haxeko/h2-watterleak-sensor/docs/img/sch/sheet-1.png

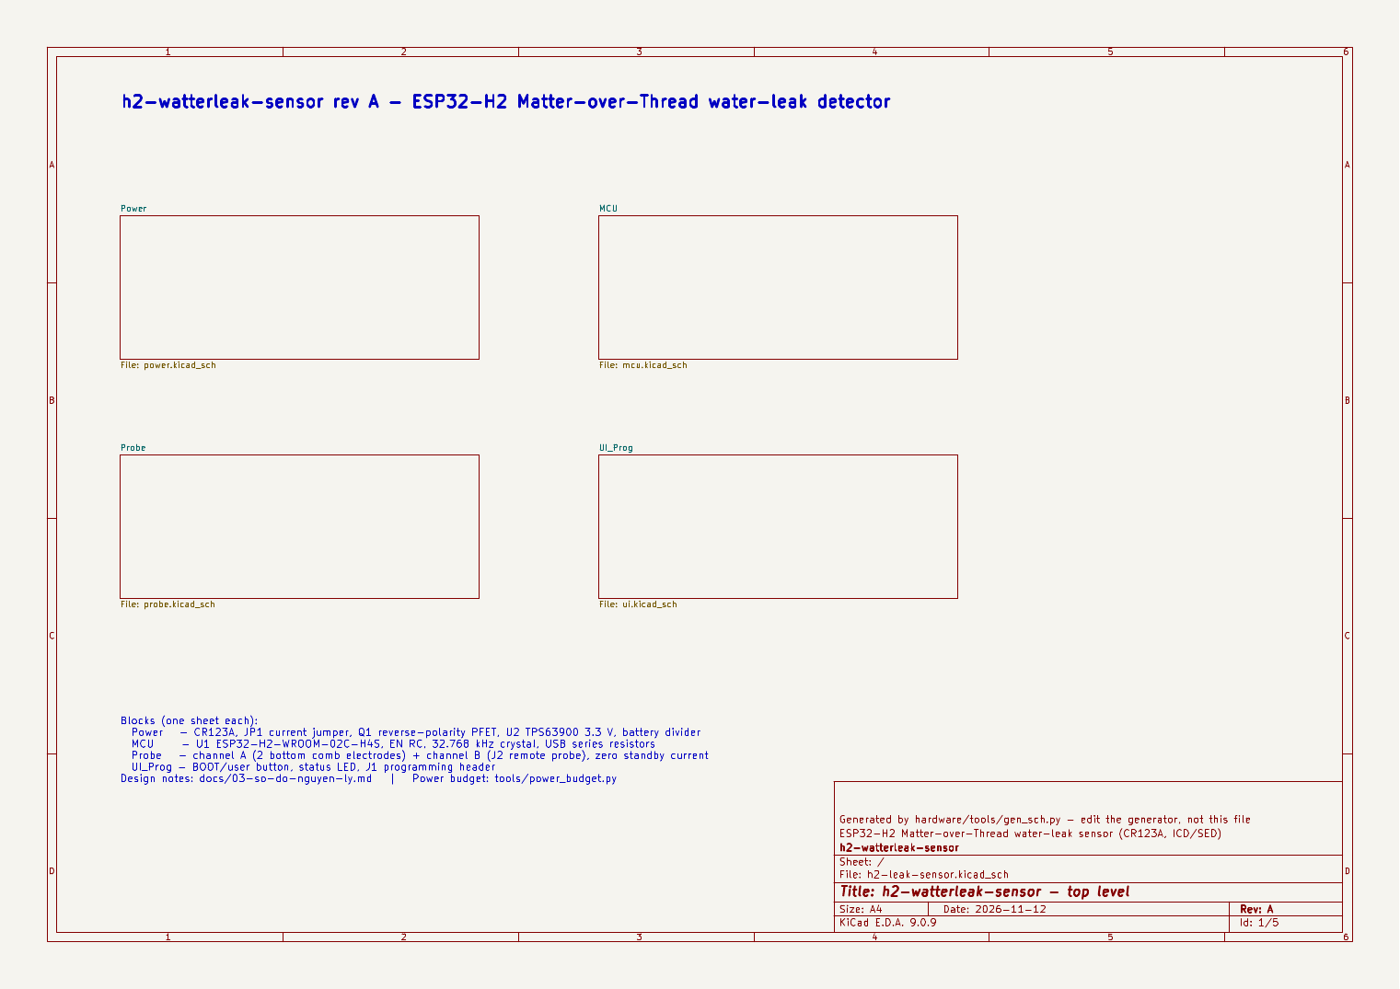
docs/img/sch/sheet-1.png
