haxeko/h2-watterleak-sensor/hardware/h2-leak-sensor/fab/h2-leak-sensor_bom_jlc.csv

Comment | Designator | Footprint | LCSC Part # | MPN | Qty
CR123A | BT1 | BatteryHolder_Bulgin_BX0123_1xCR123 |  | BX0123 (DigiKey 708-1412-ND) | 1
10u | C1 | C_0603_1608Metric_Pad1.08x0.95mm_HandSolder | C19702 | CL10A106KP8NNNC | 1
22u | C2,C3 | C_0805_2012Metric_Pad1.18x1.45mm_HandSolder | C45783 | CL21A226MAQNNNE | 2
100n | C4,C5 | C_0603_1608Metric_Pad1.08x0.95mm_HandSolder | C14663 | CC0603KRX7R9BB104 | 2
1u | C6 | C_0603_1608Metric_Pad1.08x0.95mm_HandSolder | C15849 | CL10A105KB8NNNC | 1
12p | C7,C8 | C_0603_1608Metric_Pad1.08x0.95mm_HandSolder | C38523 | CL10C120JB8NNNC | 2
10n | C9,C10 | C_0603_1608Metric_Pad1.08x0.95mm_HandSolder | C57112 | 0603B103K500NT | 2
1n | C11 | C_0603_1608Metric_Pad1.08x0.95mm_HandSolder | C1588 | CL10B102KB8NNNC | 1
PESD5V0S1BA | D1,D2,D3,D4,D5 | D_SOD-323_HandSoldering | C19224 | PESD5V0S1BA,115 | 5
PROG | J1 | PinHeader_1x08_P2.54mm_Vertical |  | 2.54 mm 1x08 header / pogo pads | 1
Remote probe | J2 | JST_PH_S2B-PH-K_1x02_P2.00mm_Horizontal | C173752 | S2B-PH-K-S(LF)(SN) | 1
2.2u | L1 | L_Sunlord_WPN4020H_HandSolder | C98361 | WPN4020H2R2MT | 1
Red | LED1 | LED_0603_1608Metric_Pad1.05x0.95mm_HandSolder | C2286 | KT-0603R | 1
DMP2035U-7 | Q1 | SOT-23_Handsoldering | C110499 | DMP2035U-7 | 1
AO3400A | Q2,Q3,Q4 | SOT-23_Handsoldering | C20917 | AO3400A | 3
0R | R1,R2 | R_0603_1608Metric_Pad0.98x0.95mm_HandSolder | C21189 | 0603WAF0000T5E | 2
16.2k | R3 | R_0603_1608Metric_Pad0.98x0.95mm_HandSolder | C22885 | 0603WAF1622T5E | 1
100k | R4,R5 | R_0603_1608Metric_Pad0.98x0.95mm_HandSolder | C25803 | 0603WAF1003T5E | 2
1M | R6,R14,R17 | R_0603_1608Metric_Pad0.98x0.95mm_HandSolder | C22935 | 0603WAF1004T5E | 3
10k | R7,R11,R12,R13,R16,R19 | R_0603_1608Metric_Pad0.98x0.95mm_HandSolder | C25804 | 0603WAF1002T5E | 6
22R | R9,R10 | R_0603_1608Metric_Pad0.98x0.95mm_HandSolder | C23345 | 0603WAF220JT5E | 2
470k | R15,R18 | R_0603_1608Metric_Pad0.98x0.95mm_HandSolder | C23178 | 0603WAF4703T5E | 2
1k | R20 | R_0603_1608Metric_Pad0.98x0.95mm_HandSolder | C21190 | 0603WAF1001T5E | 1
47k | R21 | R_0603_1608Metric_Pad0.98x0.95mm_HandSolder | C25819 | 0603WAF4702T5E | 1
TS-1187A | SW1 | SW_Push_1P1T_XKB_TS-1187A | C318884 | TS-1187A-B-A-B | 1
TPS63900DSKR | U2 | TPS63900_WSON-10_2.5x2.5mm_HandSolder | C1518762 | TPS63900DSKR | 1
32.768kHz 9pF | Y1 | Crystal_SMD_3215-2Pin_3.2x1.5mm | C99010 | Q13FC13500003 | 1
