haxeko/h2-watterleak-sensor/hardware/enclosure/h2-leak-plunger.stl

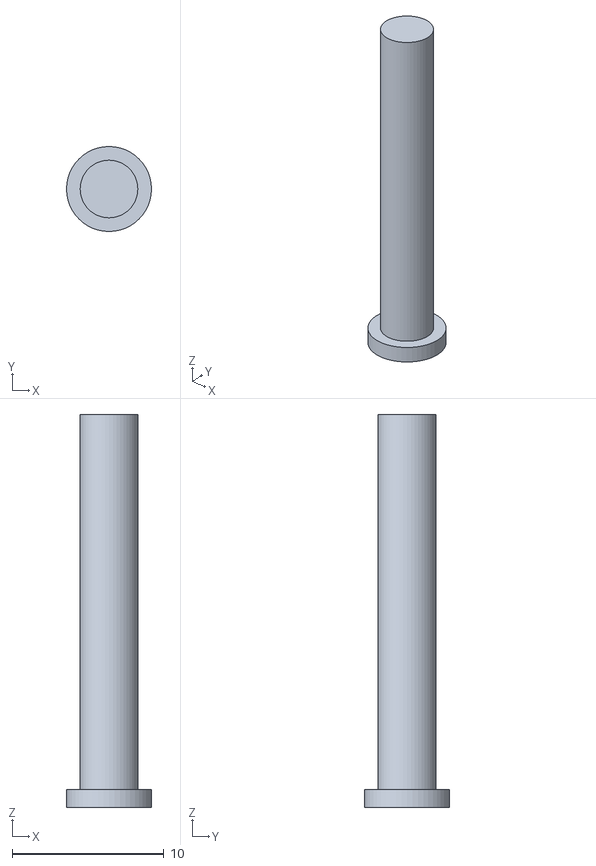
[picture p11: CAD file, 2026-11-12]
hardware/enclosure/h2-leak-plunger.stl
5.60 x 5.60 x 25.9
