haxeko/h2-watterleak-sensor/hardware/enclosure/h2-leak-base.stl

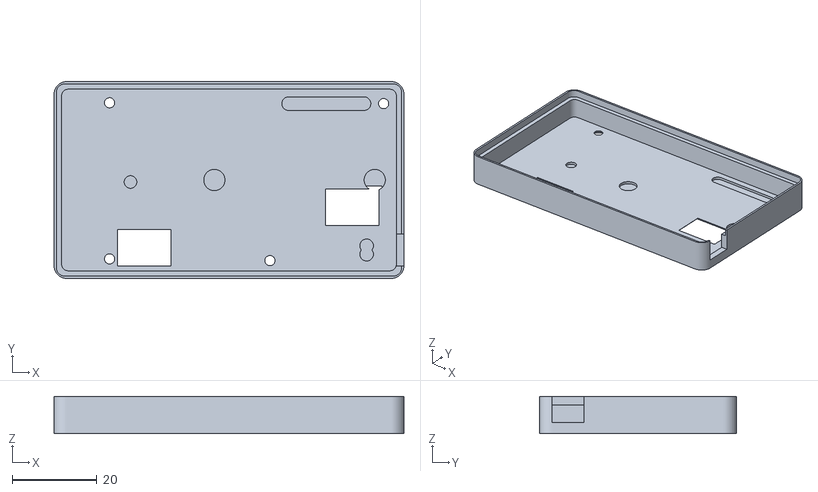
[picture p12: CAD file, 2026-11-12]
hardware/enclosure/h2-leak-base.stl
82.5 x 46.4 x 8.80
