haxeko/h2-watterleak-sensor/hardware/enclosure/h2-leak-lid.stl

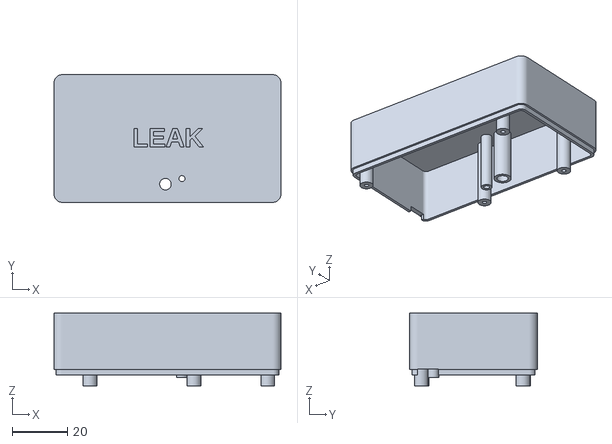
[picture p13: CAD file, 2026-11-12]
hardware/enclosure/h2-leak-lid.stl
82.5 x 46.4 x 26.4
