haxeko/h2-watterleak-sensor/hardware/h2-leak-sensor/h2-leak-sensor_schematic.pdf

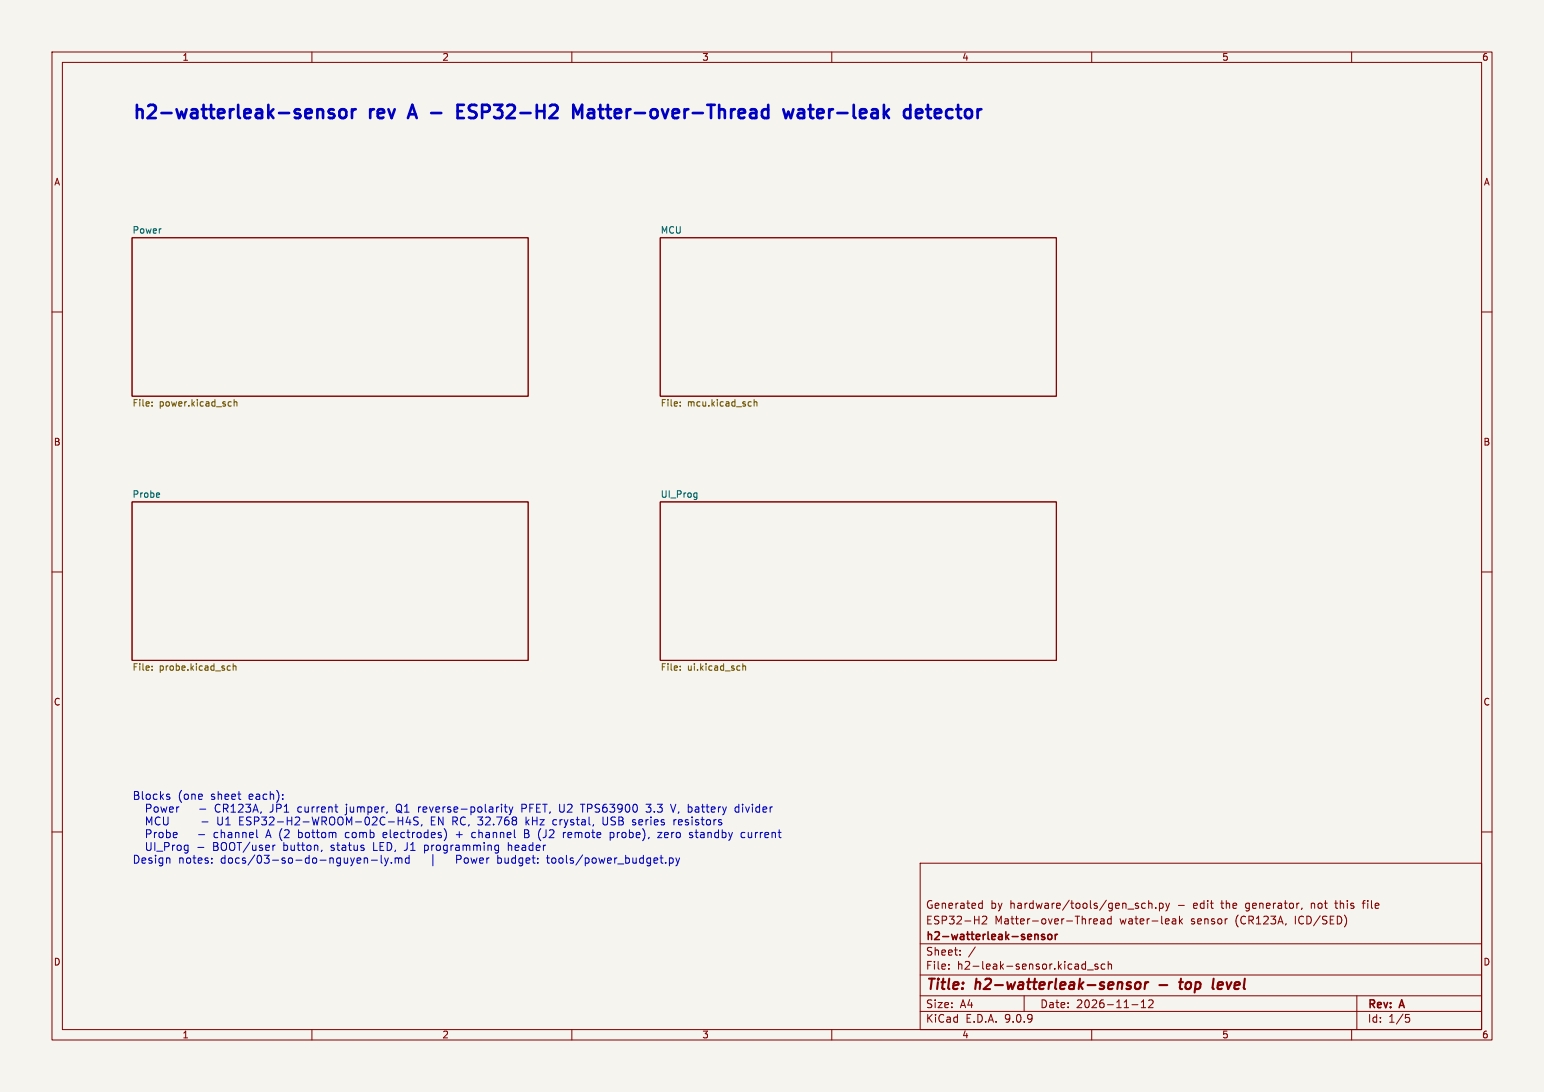
[picture p14: page 1]

File: mcu.kicad_sch Probe File: probe.kicad_sch

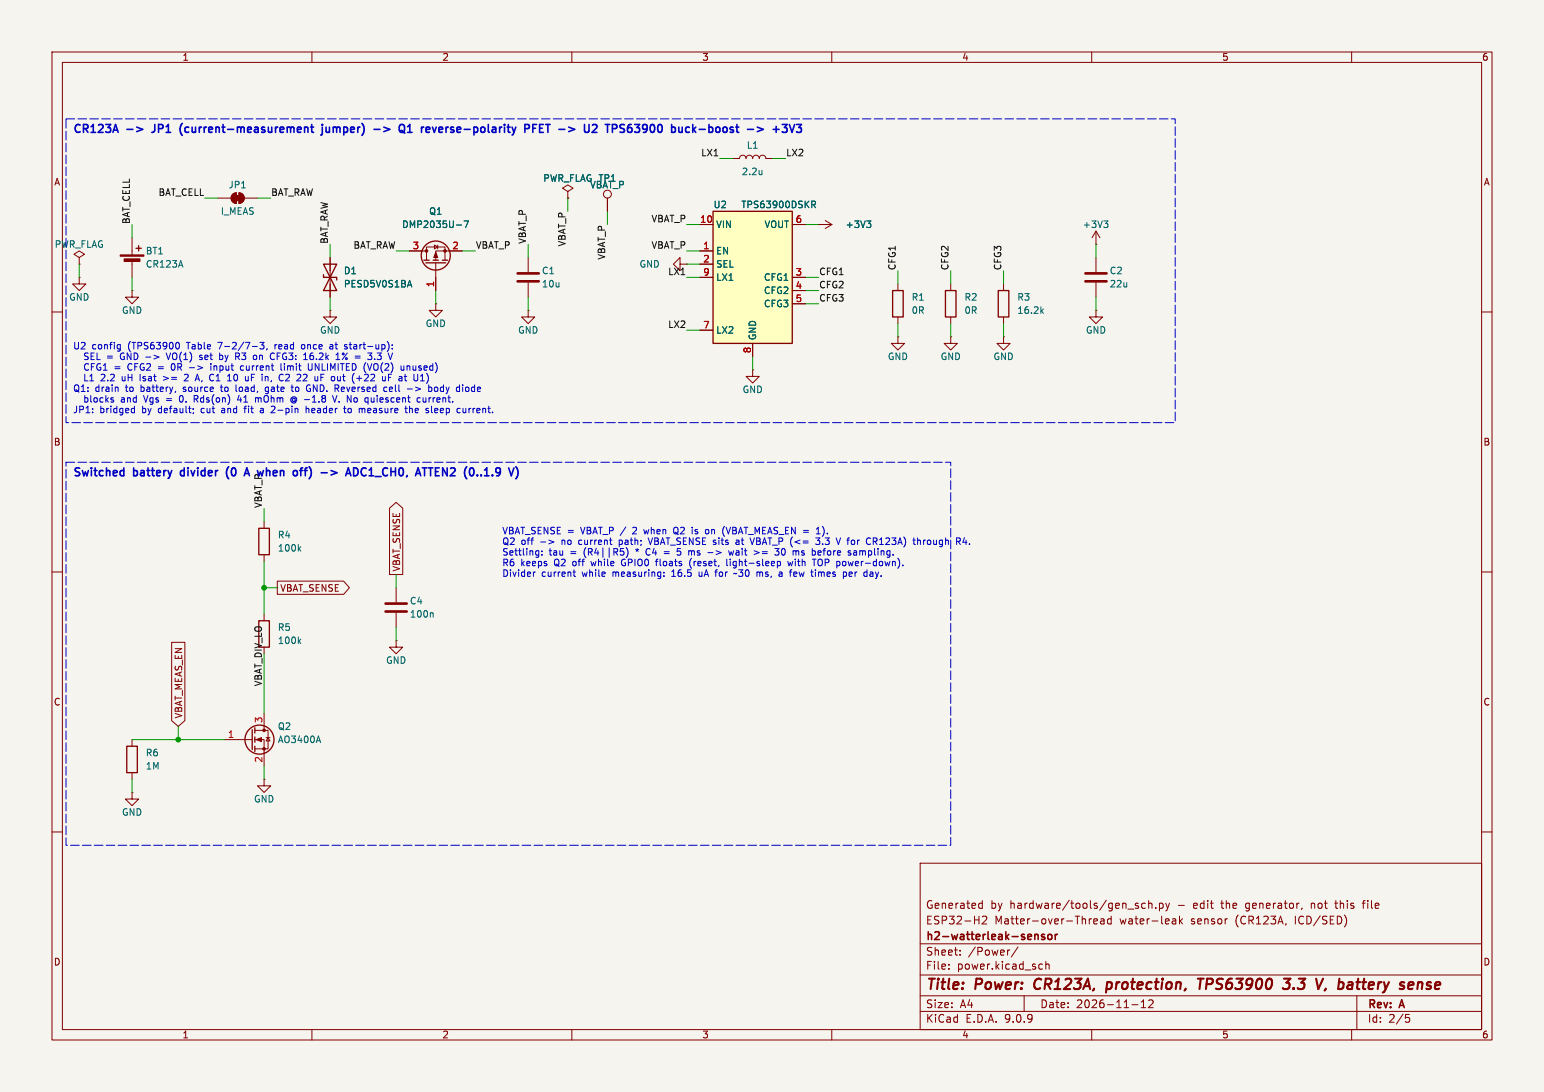
[picture p15: page 2]

8 VOUT 6 CFG1 3 CFG2 4 CFG3 5 U2 TPS63900DSKR GND GND GND

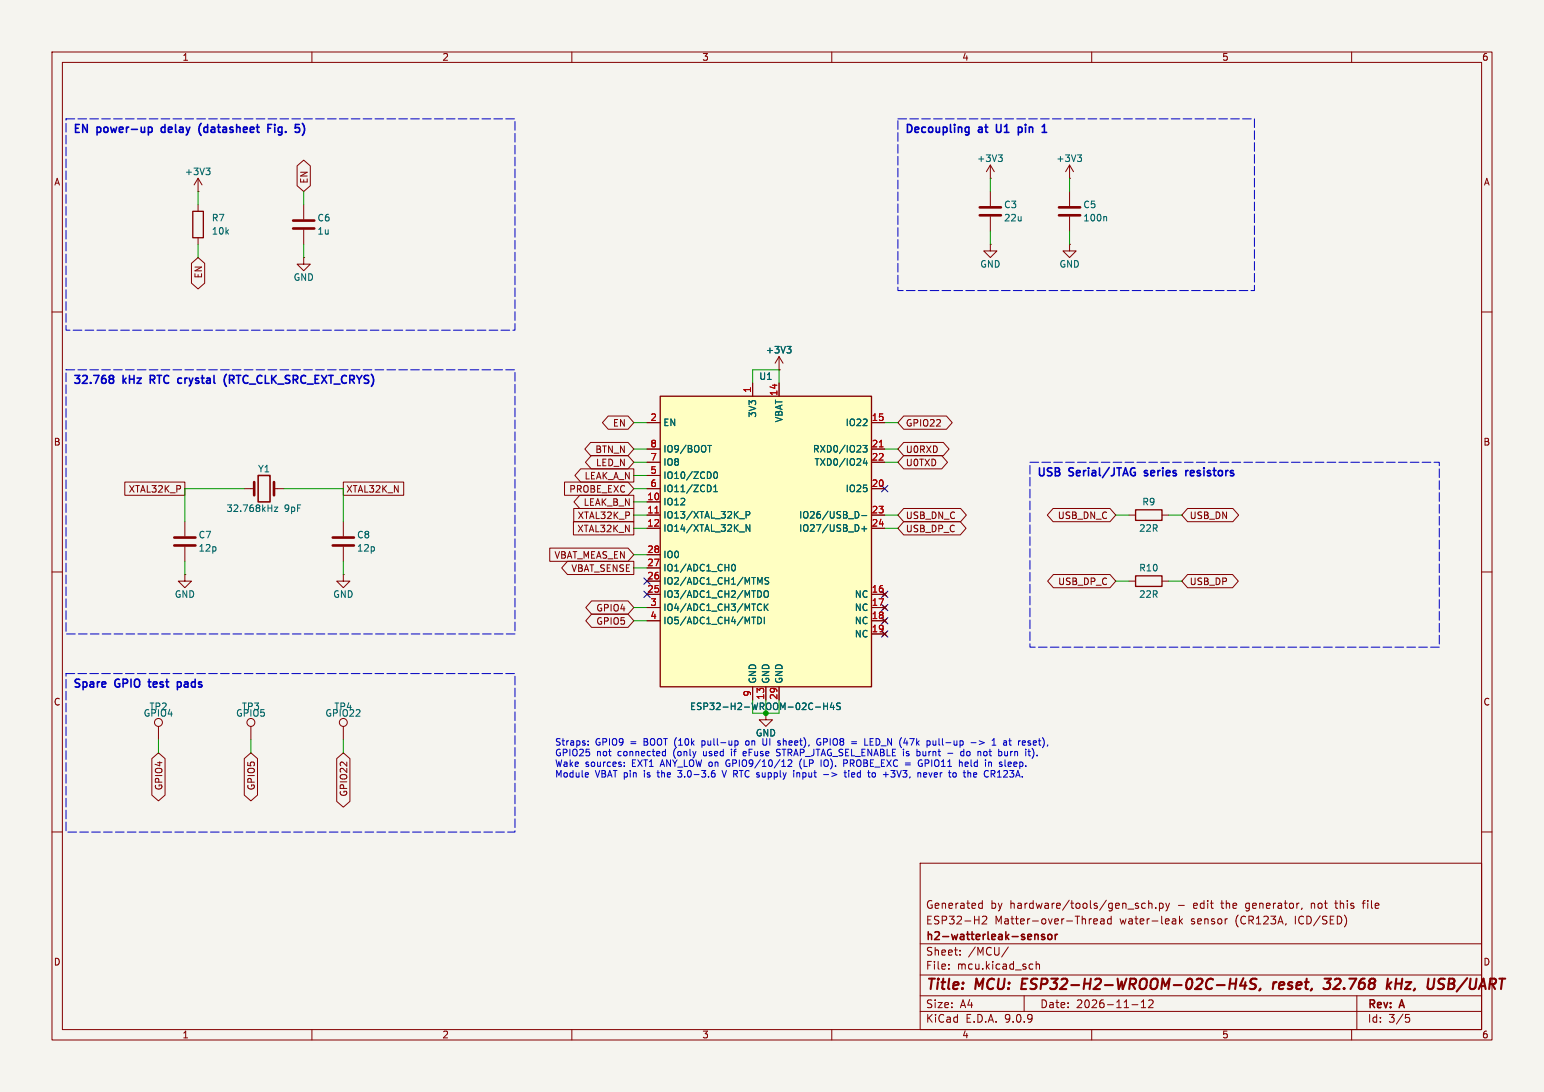
[picture p16: page 3]

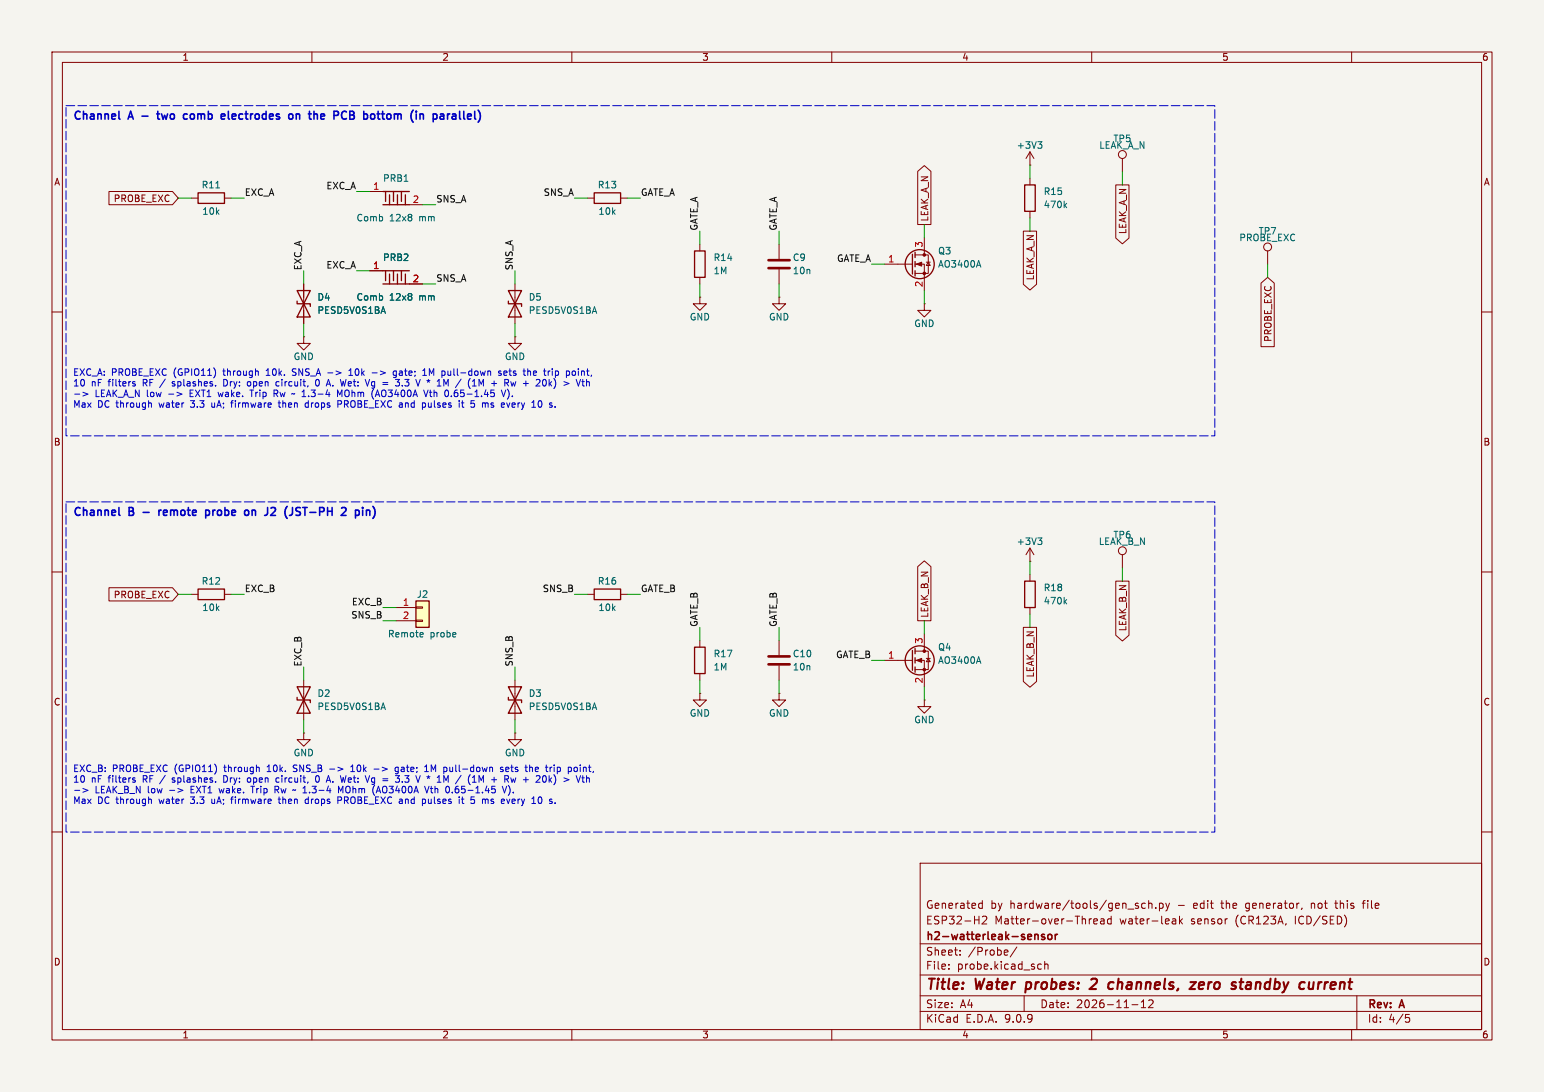
[picture p17: page 4]

Channel A - two comb electrodes on the PCB bottom (in parallel)

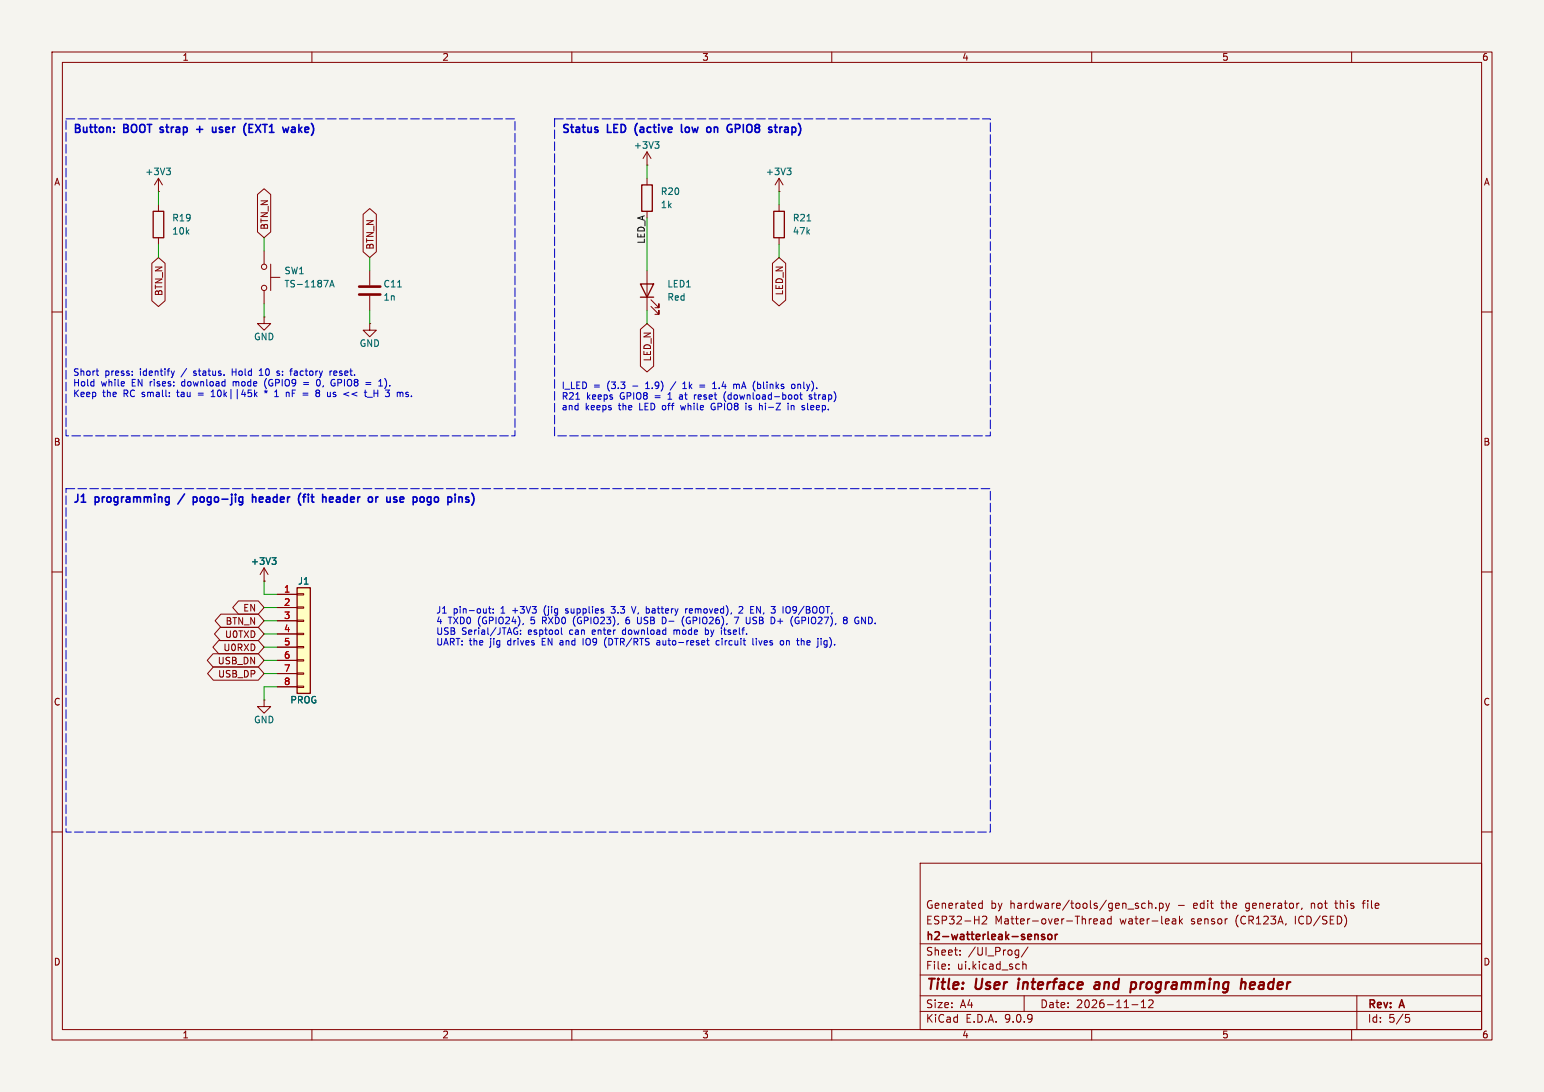
[picture p18: page 5]
