haxeko/h2-watterleak-sensor/hardware/h2-leak-sensor/fab/h2-leak-sensor_assembly_bottom.pdf

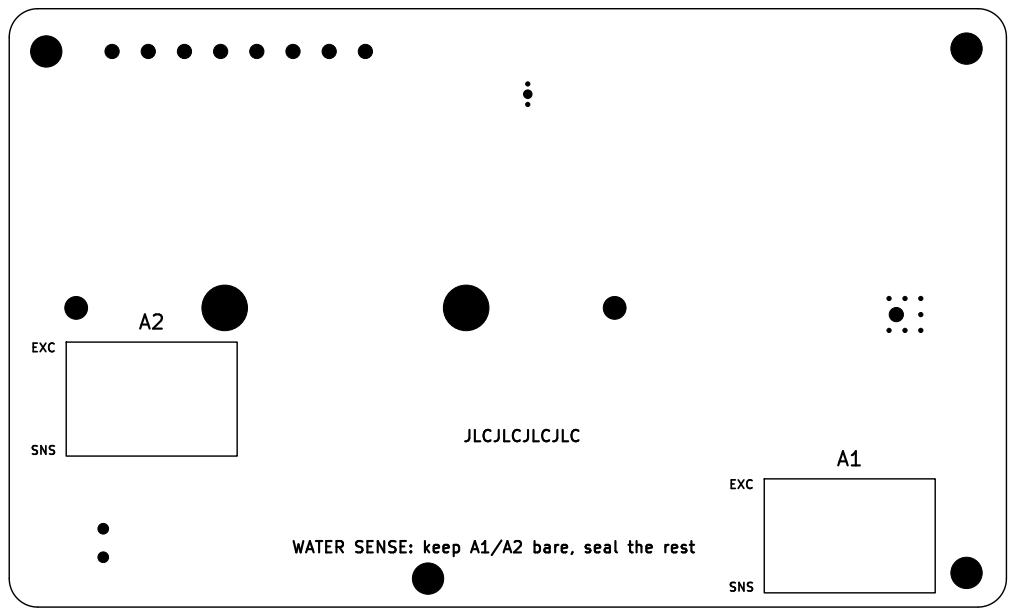
[picture p19: page 1]

Id: 1/1 Title: File: h2-leak-sensor.kicad_pcb Sheet:
