haxeko/h2-watterleak-sensor/hardware/h2-leak-sensor/fab/h2-leak-sensor_assembly_top.pdf

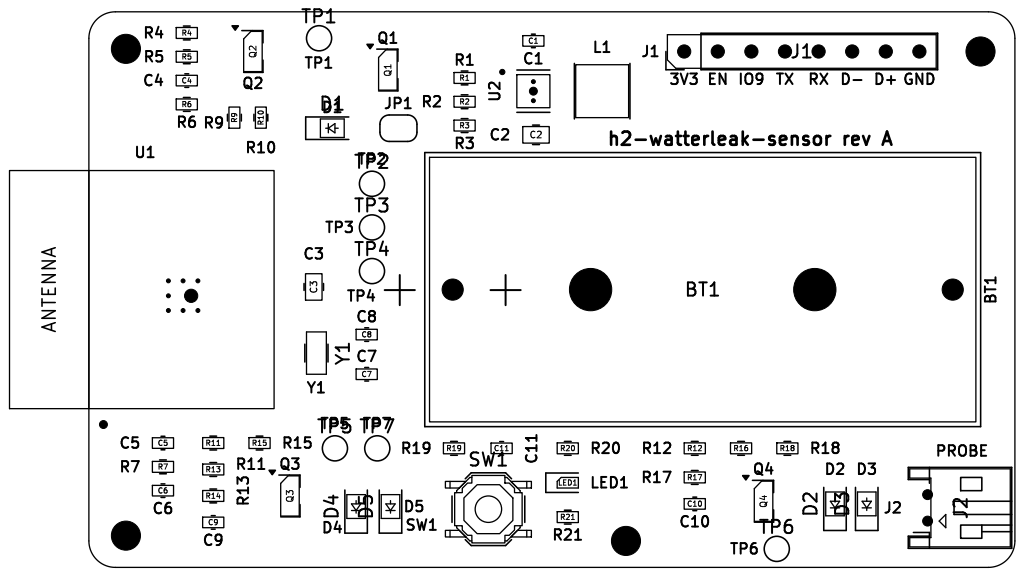
[picture p20: page 1]
