haxeko/h2-watterleak-sensor/hardware/h2-leak-sensor/h2-leak-sensor.kicad_pcb

## KiCad design hardware/h2-leak-sensor/h2-leak-sensor.kicad_pcb (2026-11-12)

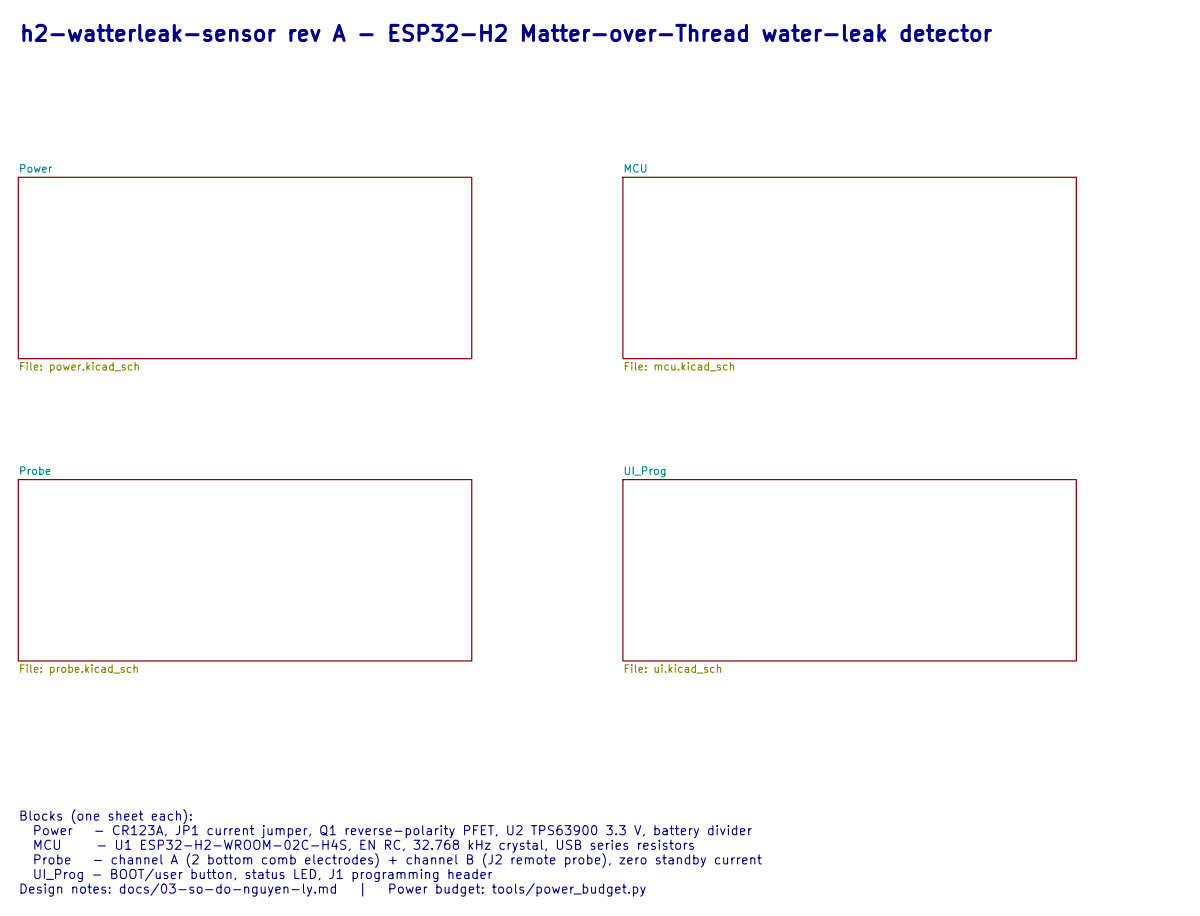
[picture p21: schematic h2-leak-sensor.kicad_sch, h2-watterleak-sensor - top level]

Notes on the sheet:
h2-watterleak-sensor rev A - ESP32-H2 Matter-over-Thread water-leak detector
Blocks (one sheet each): Power - CR123A, JP1 current jumper, Q1 reverse-polarity PFET, U2 TPS63900 3.3 V, battery divider MCU - U1 ESP32-H2-WROOM-02C-H4S, EN RC, 32.768 kHz crystal, USB series resistors Probe - channel A (2 bottom comb electrodes) + channel B (J2 remote probe), zero standby current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

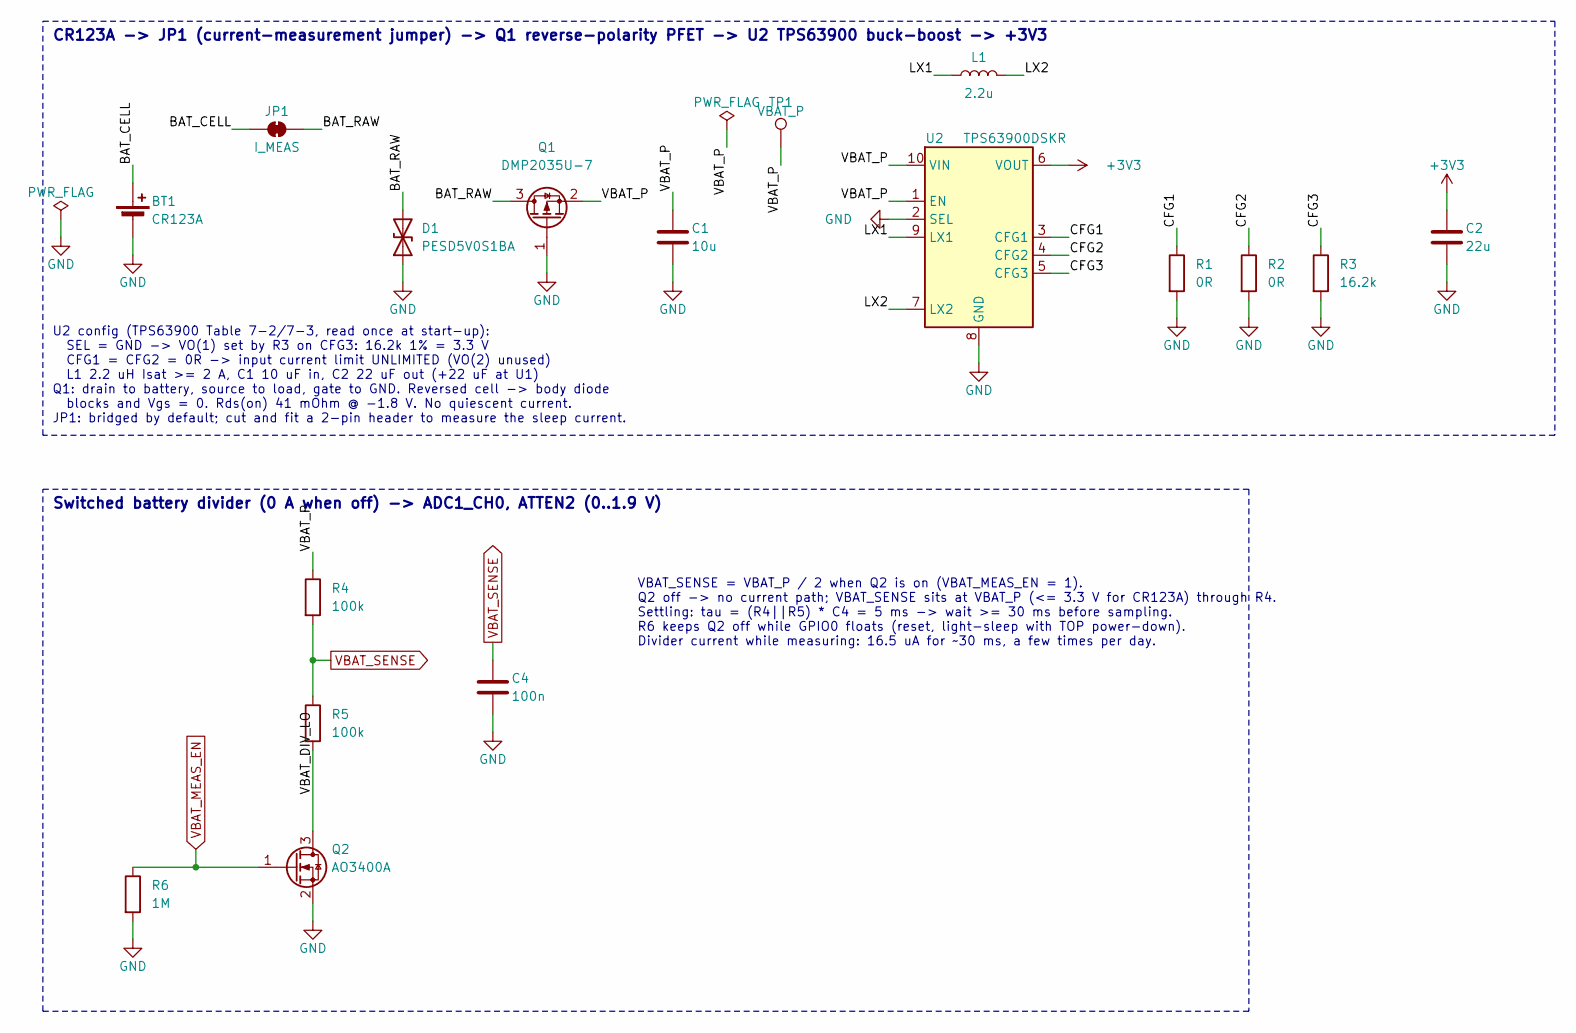
[picture p22: schematic power.kicad_sch, Power: CR123A, protection, TPS63900 3.3 V, battery sense]

Parts:
BT1: CR123A; BatteryHolder_Bulgin_BX0123_1xCR123; MPN BX0123 (DigiKey 708-1412-ND)
C1: 10u; C_0603_1608Metric_Pad1.08x0.95mm_HandSolder; MPN CL10A106KP8NNNC; LCSC C19702
C2: 22u; C_0805_2012Metric_Pad1.18x1.45mm_HandSolder; MPN CL21A226MAQNNNE; LCSC C45783
C4: 100n; C_0603_1608Metric_Pad1.08x0.95mm_HandSolder; MPN CC0603KRX7R9BB104; LCSC C14663
D1: PESD5V0S1BA; D_SOD-323_HandSoldering; MPN PESD5V0S1BA,115; LCSC C19224
JP1: I_MEAS; SolderJumper-2_P1.3mm_Bridged_RoundedPad1.0x1.5mm; MPN solder jumper (bridged)
L1: 2.2u; L_Sunlord_WPN4020H_HandSolder; MPN WPN4020H2R2MT; LCSC C98361
Q1: DMP2035U-7; SOT-23_Handsoldering; MPN DMP2035U-7; LCSC C110499
Q2: AO3400A; SOT-23_Handsoldering; MPN AO3400A; LCSC C20917
R1, R2: 0R; R_0603_1608Metric_Pad0.98x0.95mm_HandSolder; MPN 0603WAF0000T5E; LCSC C21189
R3: 16.2k; R_0603_1608Metric_Pad0.98x0.95mm_HandSolder; MPN 0603WAF1622T5E; LCSC C22885
R4, R5: 100k; R_0603_1608Metric_Pad0.98x0.95mm_HandSolder; MPN 0603WAF1003T5E; LCSC C25803
R6: 1M; R_0603_1608Metric_Pad0.98x0.95mm_HandSolder; MPN 0603WAF1004T5E; LCSC C22935
TP1: VBAT_P; TestPoint_Pad_D1.5mm; MPN test pad
U2: TPS63900DSKR; TPS63900_WSON-10_2.5x2.5mm_HandSolder; MPN TPS63900DSKR; LCSC C1518762

Connections:
+3V3: C2.1, U2.6 (VOUT); also elsewhere on the board
/Power/BAT_CELL: BT1.1 (+), JP1.1 (A)
/Power/BAT_RAW: D1.2 (A2), JP1.2 (B), Q1.3 (D)
/Power/CFG1: R1.1, U2.3 (CFG1)
/Power/CFG2: R2.1, U2.4 (CFG2)
/Power/CFG3: R3.1, U2.5 (CFG3)
/Power/LX1: L1.1, U2.9 (LX1)
/Power/LX2: L1.2, U2.7 (LX2)
/Power/VBAT_DIV_LO: Q2.3 (D), R5.2
/Power/VBAT_P: C1.1, Q1.2 (S), R4.1, TP1.1, U2.1 (EN), U2.10 (VIN)
GND: BT1.2 (-), C1.2, C2.2, C4.2, D1.1 (A1), Q1.1 (G), Q2.2 (S), R1.2, R2.2, R3.2, R6.2, U2.2 (SEL), U2.8 (GND), U2.11 (GND); also elsewhere on the board
VBAT_MEAS_EN: Q2.1 (G), R6.1; also elsewhere on the board
VBAT_SENSE: C4.1, R4.2, R5.1; also elsewhere on the board

Notes on the sheet:
CR123A -> JP1 (current-measurement jumper) -> Q1 reverse-polarity PFET -> U2 TPS63900 buck-boost -> +3V3
U2 config (TPS63900 Table 7-2/7-3, read once at start-up): SEL = GND -> VO(1) set by R3 on CFG3: 16.2k 1% = 3.3 V CFG1 = CFG2 = 0R -> input current limit UNLIMITED (VO(2) unused) L1 2.2 uH Isat >= 2 A, C1 10 uF in, C2 22 uF out (+22 uF at U1) Q1: drain to battery, source to load, gate to GND. Rever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
Switched battery divider (0 A when off) -> ADC1_CH0, ATTEN2 (0..1.9 V)
VBAT_SENSE = VBAT_P / 2 when Q2 is on (VBAT_MEAS_EN = 1). Q2 off -> no current path; VBAT_SENSE sits at VBAT_P (<= 3.3 V for CR123A) through R4. Settling: tau = (R4||R5) * C4 = 5 ms -> wait >= 30 ms before sampling. R6 keeps Q2 off while GPIO0 floats (reset, light-sleep with TOP power-down). Divide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

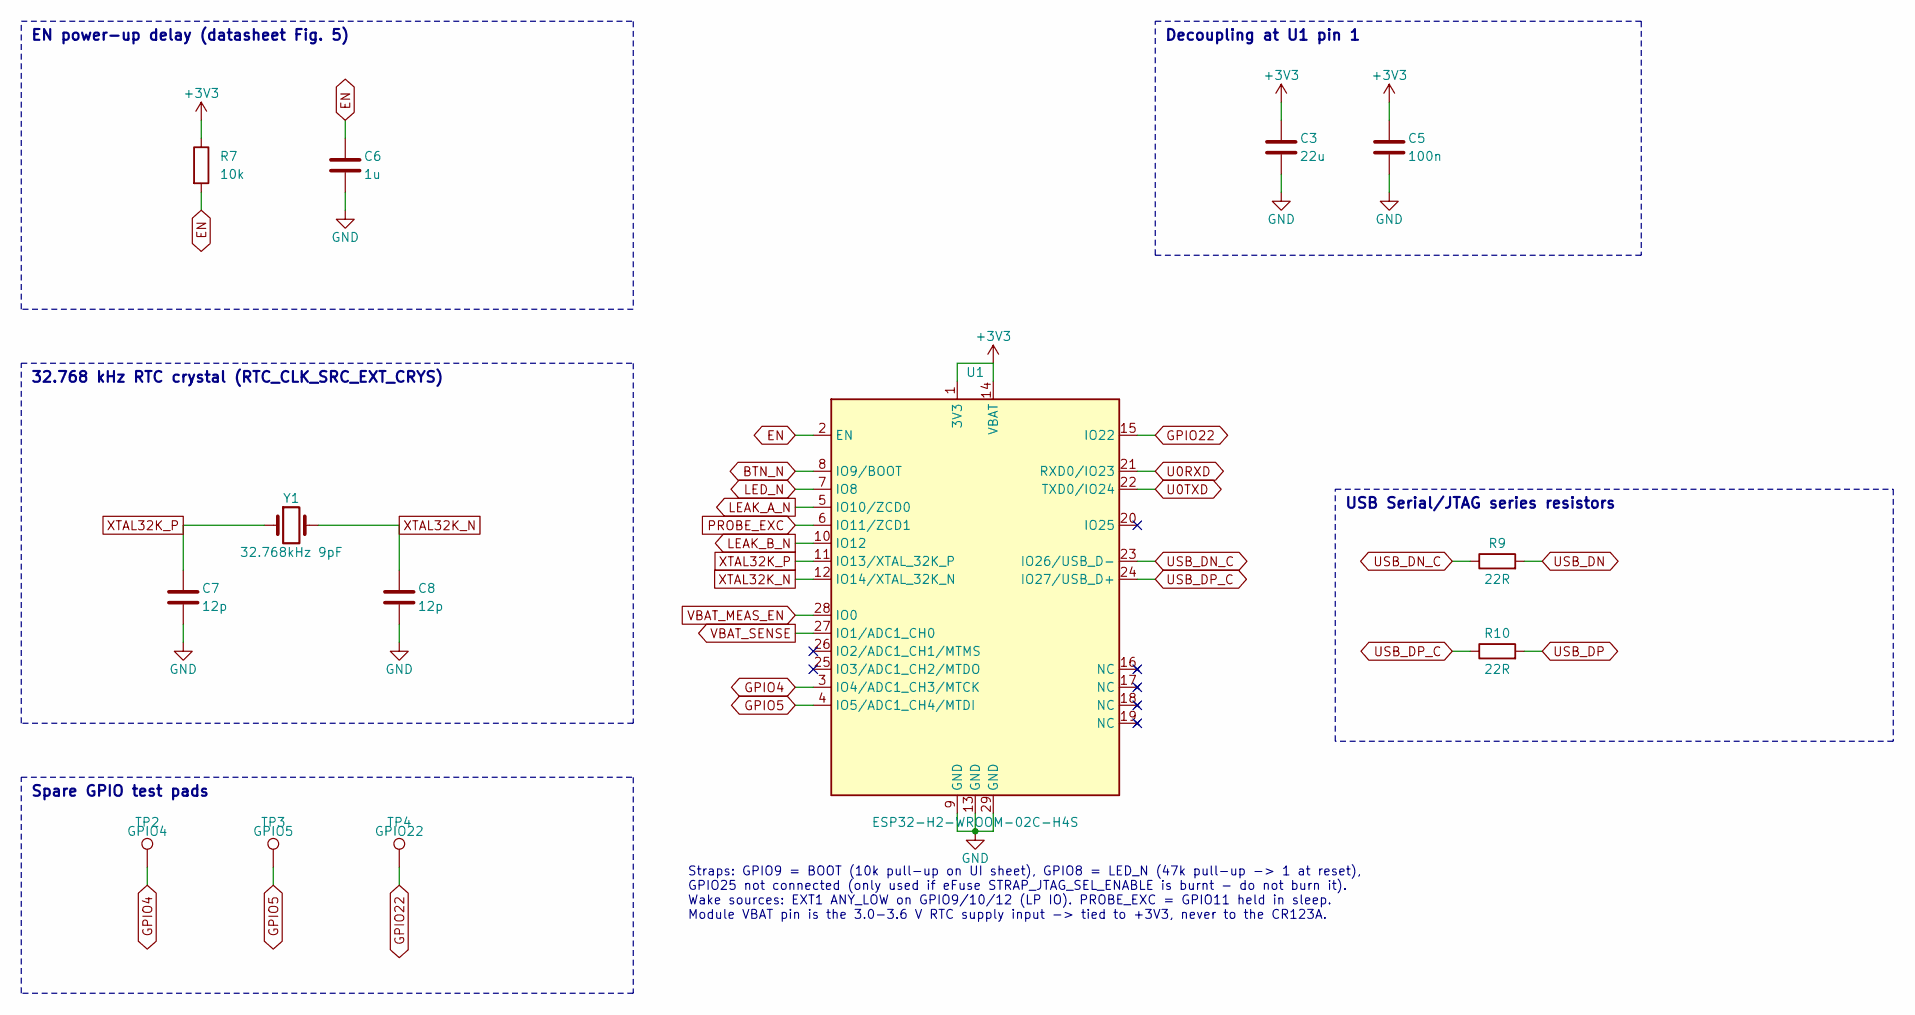
[picture p23: schematic mcu.kicad_sch, MCU: ESP32-H2-WROOM-02C-H4S, reset, 32.768 kHz, USB/UART]

Parts:
C3: 22u; C_0805_2012Metric_Pad1.18x1.45mm_HandSolder; MPN CL21A226MAQNNNE; LCSC C45783
C5: 100n; C_0603_1608Metric_Pad1.08x0.95mm_HandSolder; MPN CC0603KRX7R9BB104; LCSC C14663
C6: 1u; C_0603_1608Metric_Pad1.08x0.95mm_HandSolder; MPN CL10A105KB8NNNC; LCSC C15849
C7, C8: 12p; C_0603_1608Metric_Pad1.08x0.95mm_HandSolder; MPN CL10C120JB8NNNC; LCSC C38523
R7: 10k; R_0603_1608Metric_Pad0.98x0.95mm_HandSolder; MPN 0603WAF1002T5E; LCSC C25804
R9, R10: 22R; R_0603_1608Metric_Pad0.98x0.95mm_HandSolder; MPN 0603WAF220JT5E; LCSC C23345
TP2: GPIO4; TestPoint_Pad_D1.5mm; MPN test pad
TP3: GPIO5; TestPoint_Pad_D1.5mm; MPN test pad
TP4: GPIO22; TestPoint_Pad_D1.5mm; MPN test pad
U1: ESP32-H2-WROOM-02C-H4S; ESP32-H2-WROOM-02C; MPN ESP32-H2-WROOM-02C-H4S
Y1: 32.768kHz 9pF; Crystal_SMD_3215-2Pin_3.2x1.5mm; MPN Q13FC13500003; LCSC C99010

Connections:
+3V3: C3.1, C5.1, R7.1, U1.1 (3V3), U1.14 (VBAT); also elsewhere on the board
BTN_N: U1.8 (IO9/BOOT); also elsewhere on the board
EN: C6.1, R7.2, U1.2 (EN); also elsewhere on the board
GND: C3.2, C5.2, C6.2, C7.2, C8.2, U1.9 (GND), U1.13 (GND), U1.29 (GND); also elsewhere on the board
GPIO4: TP2.1, U1.3 (IO4/ADC1_CH3/MTCK)
GPIO5: TP3.1, U1.4 (IO5/ADC1_CH4/MTDI)
GPIO22: TP4.1, U1.15 (IO22)
LEAK_A_N: U1.5 (IO10/ZCD0); also elsewhere on the board
LEAK_B_N: U1.10 (IO12); also elsewhere on the board
LED_N: U1.7 (IO8); also elsewhere on the board
PROBE_EXC: U1.6 (IO11/ZCD1); also elsewhere on the board
U0RXD: U1.21 (RXD0/IO23); also elsewhere on the board
U0TXD: U1.22 (TXD0/IO24); also elsewhere on the board
USB_DN: R9.2; also elsewhere on the board
USB_DN_C: R9.1, U1.23 (IO26/USB_D-)
USB_DP: R10.2; also elsewhere on the board
USB_DP_C: R10.1, U1.24 (IO27/USB_D+)
VBAT_MEAS_EN: U1.28 (IO0); also elsewhere on the board
VBAT_SENSE: U1.27 (IO1/ADC1_CH0); also elsewhere on the board
XTAL32K_N: C8.1, U1.12 (IO14/XTAL_32K_N), Y1.2
XTAL32K_P: C7.1, U1.11 (IO13/XTAL_32K_P), Y1.1

Notes on the sheet:
Decoupling at U1 pin 1
EN power-up delay (datasheet Fig. 5)
32.768 kHz RTC crystal (RTC_CLK_SRC_EXT_CRYS)
USB Serial/JTAG series resistors
Spare GPIO test pads
Straps: GPIO9 = BOOT (10k pull-up on UI sheet), GPIO8 = LED_N (47k pull-up -> 1 at reset), GPIO25 not connected (only used if eFuse STRAP_JTAG_SEL_ENABLE is burnt - do not burn it). Wake sources: EXT1 ANY_LOW on GPIO9/10/12 (LP IO). PROBE_EXC = GPIO11 held in sleep. Module VBAT pin is the 3.0-3.6 V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

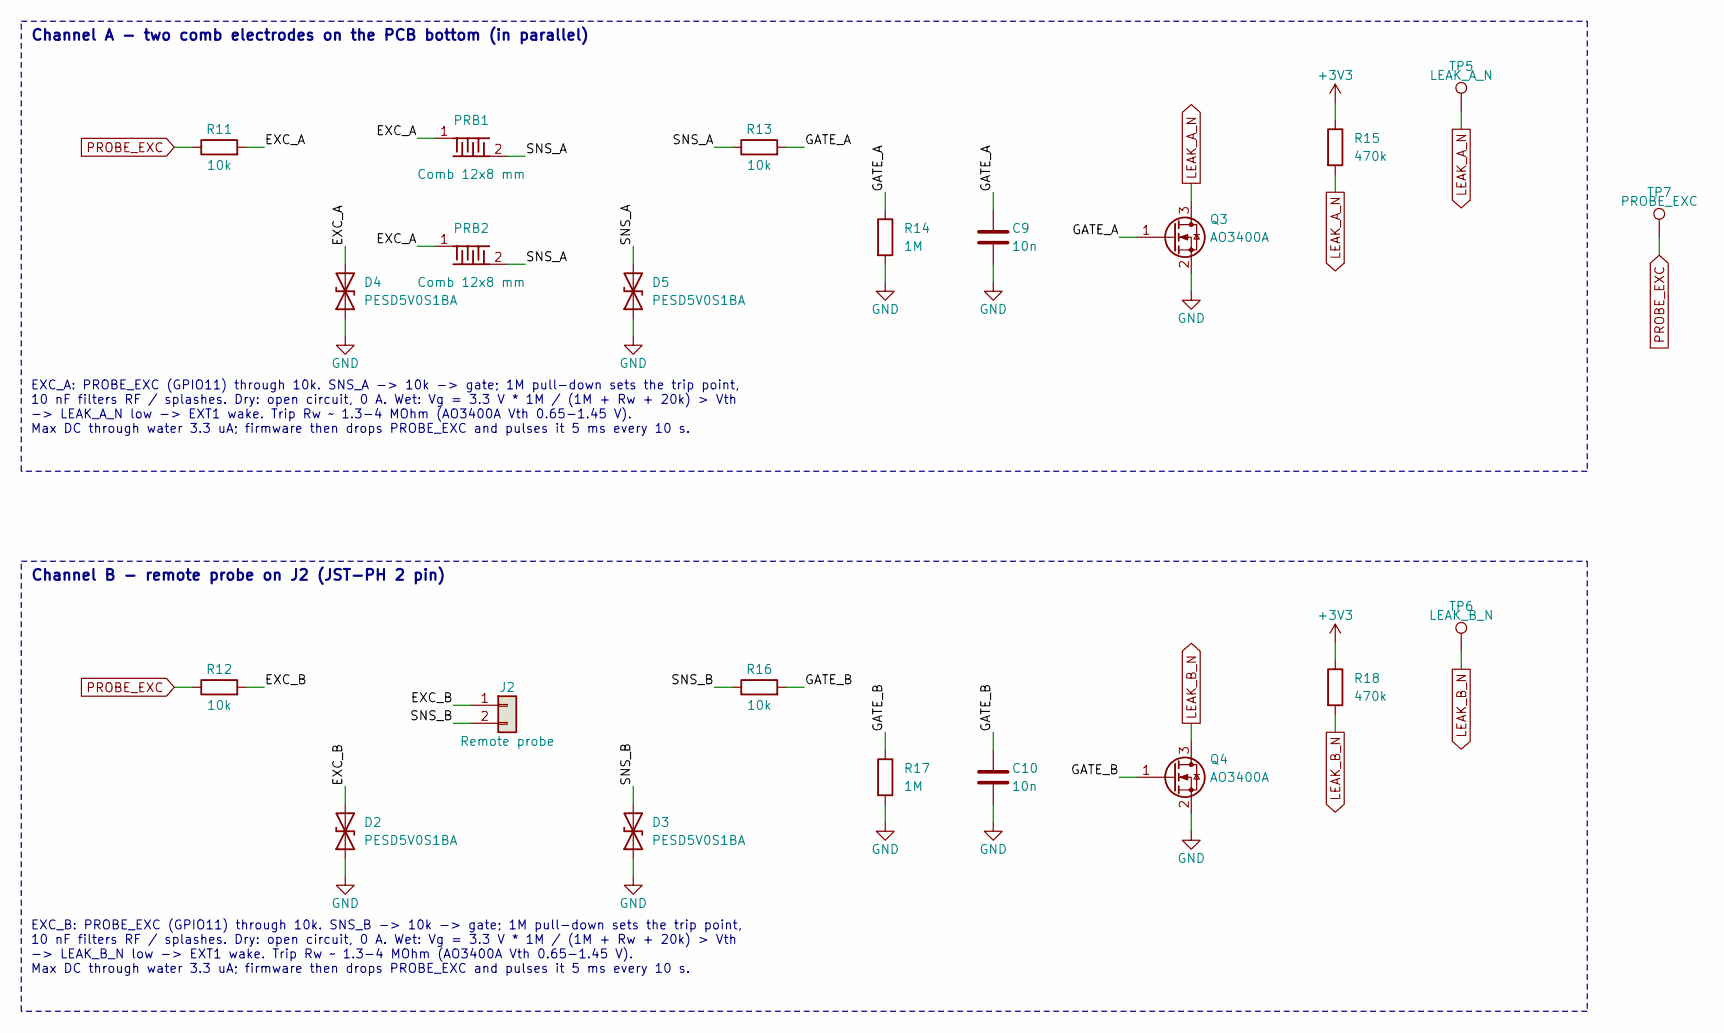
[picture p24: schematic probe.kicad_sch, Water probes: 2 channels, zero standby current]

Parts:
C9, C10: 10n; C_0603_1608Metric_Pad1.08x0.95mm_HandSolder; MPN 0603B103K500NT; LCSC C57112
D2, D3, D4, D5: PESD5V0S1BA; D_SOD-323_HandSoldering; MPN PESD5V0S1BA,115; LCSC C19224
J2: Remote probe; JST_PH_S2B-PH-K_1x02_P2.00mm_Horizontal; MPN S2B-PH-K-S(LF)(SN); LCSC C173752
PRB1, PRB2: Comb 12x8 mm; Electrode_Comb_12x8mm; MPN PCB copper (ENIG)
Q3, Q4: AO3400A; SOT-23_Handsoldering; MPN AO3400A; LCSC C20917
R11, R12, R13, R16: 10k; R_0603_1608Metric_Pad0.98x0.95mm_HandSolder; MPN 0603WAF1002T5E; LCSC C25804
R14, R17: 1M; R_0603_1608Metric_Pad0.98x0.95mm_HandSolder; MPN 0603WAF1004T5E; LCSC C22935
R15, R18: 470k; R_0603_1608Metric_Pad0.98x0.95mm_HandSolder; MPN 0603WAF4703T5E; LCSC C23178
TP5: LEAK_A_N; TestPoint_Pad_D1.5mm; MPN test pad
TP6: LEAK_B_N; TestPoint_Pad_D1.5mm; MPN test pad
TP7: PROBE_EXC; TestPoint_Pad_D1.5mm; MPN test pad

Connections:
+3V3: R15.1, R18.1; also elsewhere on the board
/Probe/EXC_A: D4.2 (A2), PRB1.1 (EXC), PRB2.1 (EXC), R11.2
/Probe/EXC_B: D2.2 (A2), J2.1, R12.2
/Probe/GATE_A: C9.1, Q3.1 (G), R13.2, R14.1
/Probe/GATE_B: C10.1, Q4.1 (G), R16.2, R17.1
/Probe/SNS_A: D5.2 (A2), PRB1.2 (SNS), PRB2.2 (SNS), R13.1
/Probe/SNS_B: D3.2 (A2), J2.2, R16.1
GND: C9.2, C10.2, D2.1 (A1), D3.1 (A1), D4.1 (A1), D5.1 (A1), Q3.2 (S), Q4.2 (S), R14.2, R17.2; also elsewhere on the board
LEAK_A_N: Q3.3 (D), R15.2, TP5.1; also elsewhere on the board
LEAK_B_N: Q4.3 (D), R18.2, TP6.1; also elsewhere on the board
PROBE_EXC: R11.1, R12.1, TP7.1; also elsewhere on the board

Notes on the sheet:
Channel A - two comb electrodes on the PCB bottom (in parallel)
EXC_A: PROBE_EXC (GPIO11) through 10k. SNS_A -> 10k -> gate; 1M pull-down sets the trip point, 10 nF filters RF / splashes. Dry: open circuit, 0 A. Wet: Vg = 3.3 V * 1M / (1M + Rw + 20k) > Vth -> LEAK_A_N low -> EXT1 wake. Trip Rw ~ 1.3-4 MOhm (AO3400A Vth 0.65-1.45 V). Max DC through water 3.3 uA;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
Channel B - remote probe on J2 (JST-PH 2 pin)
EXC_B: PROBE_EXC (GPIO11) through 10k. SNS_B -> 10k -> gate; 1M pull-down sets the trip point, 10 nF filters RF / splashes. Dry: open circuit, 0 A. Wet: Vg = 3.3 V * 1M / (1M + Rw + 20k) > Vth -> LEAK_B_N low -> EXT1 wake. Trip Rw ~ 1.3-4 MOhm (AO3400A Vth 0.65-1.45 V). Max DC through water 3.3 uA;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

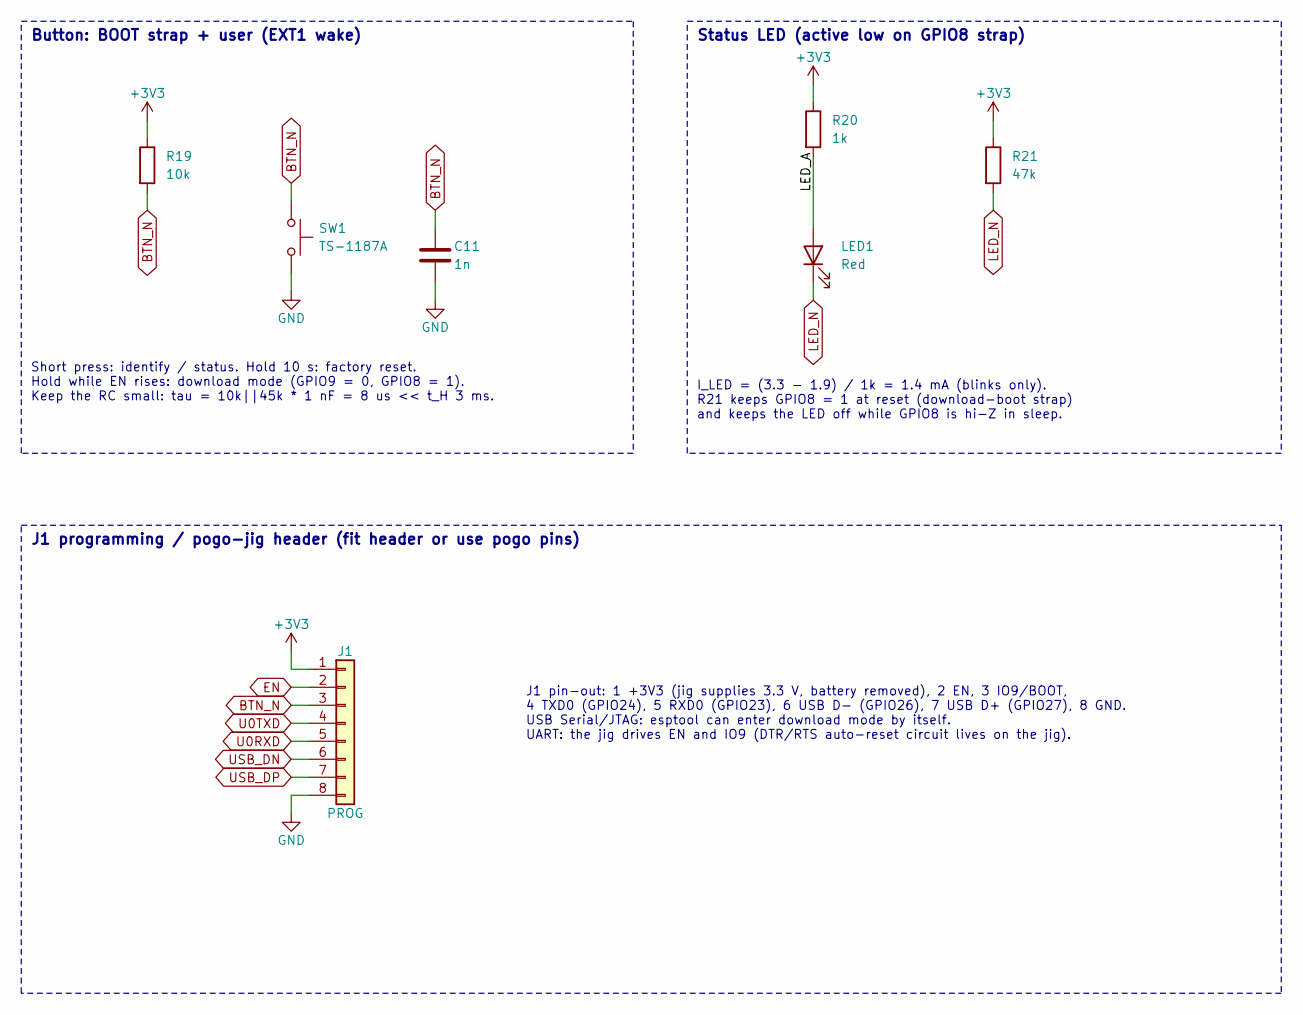
[picture p25: schematic ui.kicad_sch, User interface and programming header]

Parts:
C11: 1n; C_0603_1608Metric_Pad1.08x0.95mm_HandSolder; MPN CL10B102KB8NNNC; LCSC C1588
J1: PROG; PinHeader_1x08_P2.54mm_Vertical; MPN 2.54 mm 1x08 header / pogo pads
LED1: Red; LED_0603_1608Metric_Pad1.05x0.95mm_HandSolder; MPN KT-0603R; LCSC C2286
R19: 10k; R_0603_1608Metric_Pad0.98x0.95mm_HandSolder; MPN 0603WAF1002T5E; LCSC C25804
R20: 1k; R_0603_1608Metric_Pad0.98x0.95mm_HandSolder; MPN 0603WAF1001T5E; LCSC C21190
R21: 47k; R_0603_1608Metric_Pad0.98x0.95mm_HandSolder; MPN 0603WAF4702T5E; LCSC C25819
SW1: TS-1187A; SW_Push_1P1T_XKB_TS-1187A; MPN TS-1187A-B-A-B; LCSC C318884

Connections:
+3V3: J1.1, R19.1, R20.1, R21.1; also elsewhere on the board
/UI_Prog/LED_A: LED1.2 (A), R20.2
BTN_N: C11.1, J1.3, R19.2, SW1.1; also elsewhere on the board
EN: J1.2; also elsewhere on the board
GND: C11.2, J1.8, SW1.2; also elsewhere on the board
LED_N: LED1.1 (K), R21.2; also elsewhere on the board
U0RXD: J1.5; also elsewhere on the board
U0TXD: J1.4; also elsewhere on the board
USB_DN: J1.6; also elsewhere on the board
USB_DP: J1.7; also elsewhere on the board

Notes on the sheet:
Button: BOOT strap + user (EXT1 wake)
Short press: identify / status. Hold 10 s: factory reset. Hold while EN rises: download mode (GPIO9 = 0, GPIO8 = 1). Keep the RC small: tau = 10k||45k * 1 nF = 8 us << t_H 3 ms.
Status LED (active low on GPIO8 strap)
I_LED = (3.3 - 1.9) / 1k = 1.4 mA (blinks only). R21 keeps GPIO8 = 1 at reset (download-boot strap) and keeps the LED off while GPIO8 is hi-Z in sleep.
J1 programming / pogo-jig header (fit header or use pogo pins)
J1 pin-out: 1 +3V3 (jig supplies 3.3 V, battery removed), 2 EN, 3 IO9/BOOT, 4 TXD0 (GPIO24), 5 RXD0 (GPIO23), 6 USB D- (GPIO26), 7 USB D+ (GPIO27), 8 GND. USB Serial/JTAG: esptool can enter download mode by itself. UART: the jig drives EN and IO9 (DTR/RTS auto-reset circuit lives on the jig).

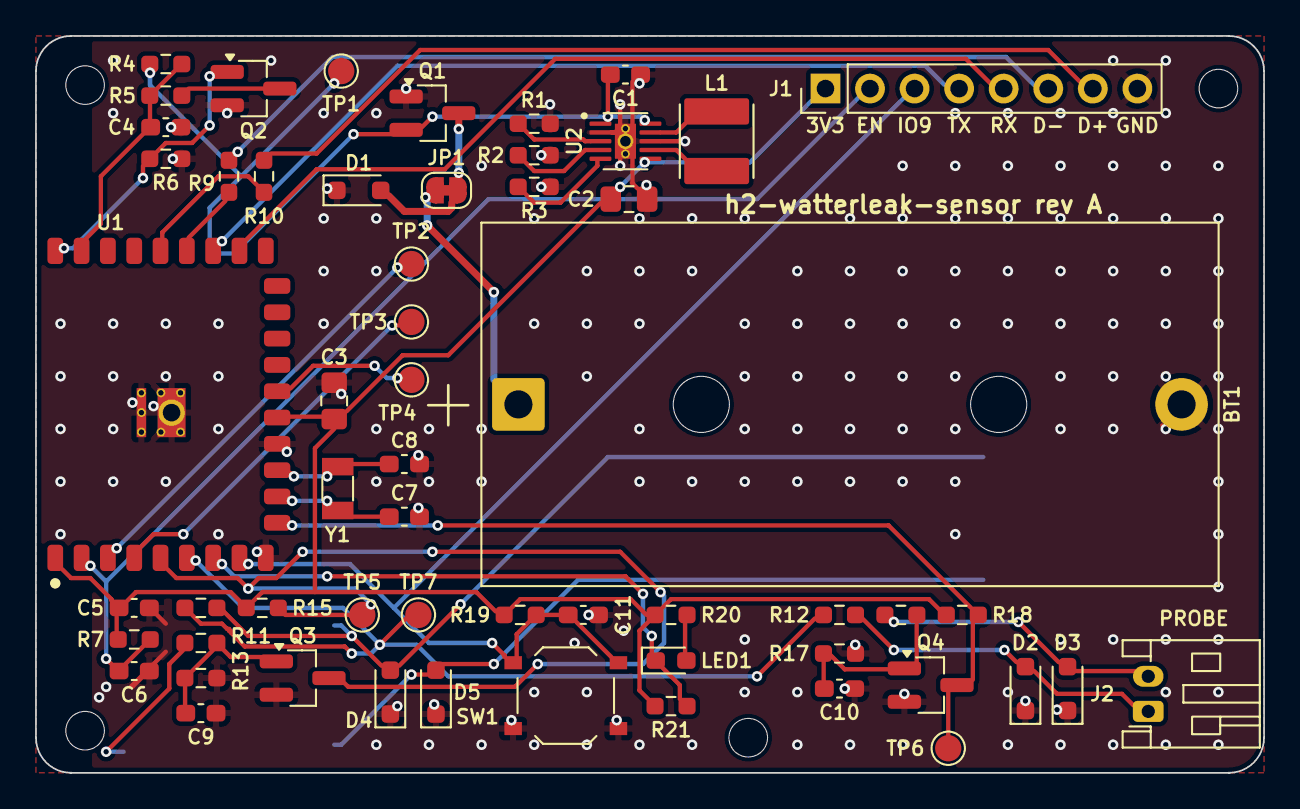
[picture p26: board h2-leak-sensor.kicad_pcb from above]

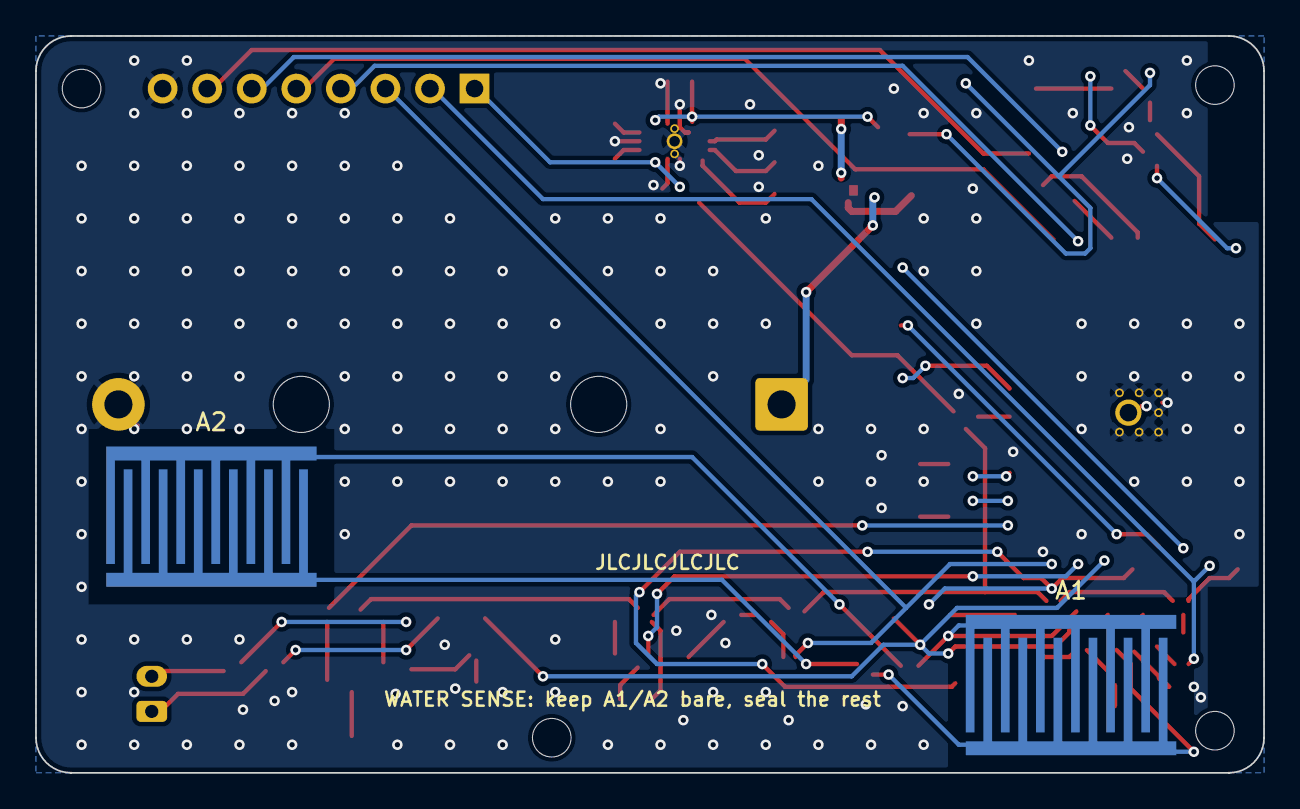
[picture p27: board h2-leak-sensor.kicad_pcb from below]

Board: 2 copper layers, 70.0 x 42.0 mm, 63 parts (2 on the bottom side), 37 nets.

Other parts of the board:
H1, H2, H3, H4: MountingHole_M2; MountingHole_2.2mm_M2
