haxeko/h2-watterleak-sensor/(commit log)

2026-11-12 Phase 1: requirements and power budget draft
    Add the phase-1 requirements document (Vietnamese) with the verified
    ESP32-H2 / TPS63900 datasheet figures, the sleep-architecture decision,
    the zero-quiescent probe front-end principle and battery-life estimates.
    Add tools/power_budget.py, a parametric current/energy model used to
    generate the tables (re-run with measured values in phase 6).
    Claude-Session: https://claude.ai/code/session_01TvrXHTuvm137scmjCamvNk
2026-11-12 Phase 1: record decisions (CR123A, WROOM-02C-H4S, no buzzer, 2 probe channels)
    Mark the phase-1 requirements as final, drop the buzzer from the
    requirements and the energy model (leak-event cost now 0.024 mAh),
    and keep the buzzer figure only as a reference row.
    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
    [power_budget.py]
2026-11-12 Phase 2: block diagram and GPIO assignment draft
    Block diagram (Mermaid + ASCII), power tree with per-block currents,
    full ESP32-H2-WROOM-02C pin map with reset/sleep behaviour, strapping
    verification (GPIO8/9/25, EN timing), EXT1 wake plan, probe state
    machine and a draft board_pins.h for the firmware.
    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
2026-11-12 Phase 2: record pre-phase-3 decisions (KiCad 9, JST-PH, hand assembly, single LED)
    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
2026-11-12 Phase 3: KiCad 9 hierarchical schematic, custom library and BOM
    - hardware/tools: dependency-free S-expression helper plus generators
    for the project library (ESP32-H2-WROOM-02C symbol and footprint from
    the datasheet land pattern, hand-solder TPS63900 and 4020 inductor
    footprints, interdigitated ENIG comb electrode) and for the schematic.
    - hardware/h2-leak-sensor: root sheet plus Power, MCU, Probe and UI_Prog
    sheets; KiCad 9.0.9 ERC reports 0 violations at all severities; PDF,
    grouped BOM with LCSC codes (module excluded as requested).
    - docs/03: per-block design values and calculations, BOM, hand
    assembly order; docs/01-02 updated (5 ms wet-probe pulse, J1 order).
    Co-Authored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
    [h2-leak-sensor.kicad_sch, h2-leak-sensor_bom.csv, mcu.kicad_sch, power.kicad_sch, probe.kicad_sch, ui.kicad_sch]
2026-11-12 Phase 4: PCB layout, routing, fab outputs and 3D-printable enclosure
    - gen_pcb.py: 70 x 42 mm 2-layer board from the schematic netlist, placement,
    JLCPCB-friendly DRC rules/net classes, GND pours, antenna and electrode
    keep-outs, collision-free silkscreen placement, JLC order-number marker
    - route.py: grid A* router (0.1 mm grid aligned to the placement grid, exact
    geometry clearances), pre-routed TPS63900 power-loop GND, GND fan-out and
    stitching, union-find GND connectivity check with via / track / rip-up
    repair, --gnd-only mode for hand-edited boards
    - fab_outputs.py: Gerber zip, Excellon drill, JLCPCB BOM/CPL (module and
    board-only items excluded), assembly PDFs, DRC report
    -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
    [h2-leak-base.stl, h2-leak-enclosure.scad, h2-leak-lid.stl, h2-leak-plunger.stl, h2-leak-sensor.kicad_pcb, h2-leak-sensor_bom_jlc.csv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]
2026-11-12 Phase 5: ESP-IDF v5.5.5 + esp-matter v1.6 firmware for the leak sensor
    - Water Leak Detector (0x0043) on EP1 with Identify and Boolean State; StateValue set
    through BooleanStateCluster::SetStateValue (managed internally in esp-matter v1.6),
    which also emits StateChange
    - Power Source (BAT + REPLC) on EP1: CR123A designations, voltage, percent from
    min(charge counter, voltage table), charge level and replacement flag
    - ICD SIT: slow poll 15 s, fast poll 200 ms, active 1 s, idle 1 h; auto light sleep
    with TOP power-down, 32 kHz crystal, Thread TX power +9 dBm
    - EXT1 + GPIO wake-up inputs for button and both probe channels; probe state machine
    ARMED_DRY -> CONFIRMING (3 x 100 ms) -> W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
    [partitions.csv]
2026-11-12 Phase 6: test plan, PPK2 analyser, water simulator and HA test runner
    - docs/06-ke-hoach-test.md: bench setup (PPK2 source/ampere meter on BT1 or JP1,
    logic channels on the simulator mark and PROBE_EXC), test cases T0-T15 with
    acceptance criteria mapped to FR/NFR, sleep-current debugging table
    - tools/ppk2_analyze.py: streams Power Profiler CSV exports; floor/average current,
    radio bursts, slow-poll period, charge per poll vs the phase 1 model, CR123A life,
    leak confirm / first-packet latency, transient rejection, wet pulse timing
    - tools/leak_sim/leak_sim.ino: optocoupler water simulator on J2 (W / D / P <ms>)
    - tools/leak_test_runner.py: drives the simulator and listens to Home Ass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
    [app_main.cpp, app_matter.cpp, app_matter.h, leak_sim.ino, leak_test_runner.py, ppk2_analyze.py, status_led.cpp, status_led.h]
